alvarop/usb_c_cable_tester/img/front_v2.4.jpg

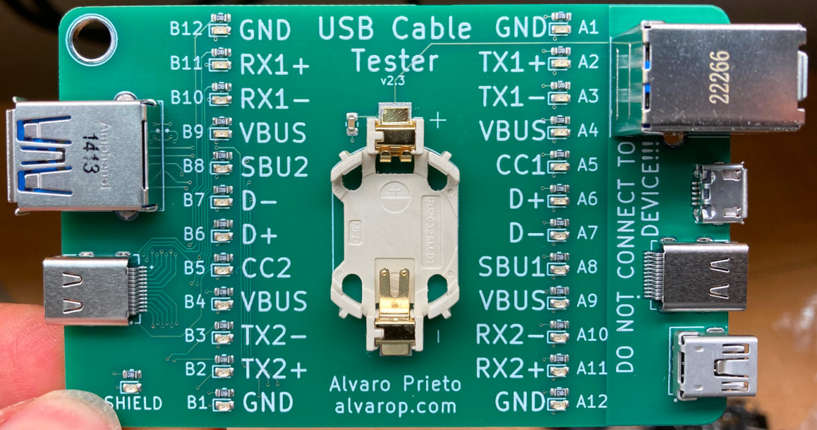
img/front_v2.4.jpg
