alvarop/usb_c_cable_tester/(threads)

Thread 2 (2022-11-21):

Unsure if JLCPCB got this right

voltagex, 2022-11-21:
(this would be better suited for GitHub Discussions but they're not enabled here)

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

I've sent them your photos back - it looks like they've dropped most of the parts off the board!

alvarop, 2022-11-21:
@voltagex This is correct. The left side is what they will use :D
It is confusing though

voltagex, 2022-11-21:
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

To me it seems like there's only 3 components they're going to use? Some connectors are missing?

I guess I can just continue with the order and see what arrives.

voltagex, 2022-11-21:
OK, yeah, the 2D render seems correct.
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

alvarop, 2022-11-22:
:D

voltagex, 2022-11-29:
This arrived today. I can get it to light up by probing with a multimeter, but not with a coin cell inserted. I do not like the battery holder at all

tedder, 2022-11-29:
I would *love* to just get this off Tindie.

alvarop, 2022-11-29:
Yeah, the battery holder isn’t great, you have to make sure you go over the negative and under the positive.
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

Closed 2022-11-22.

Thread 3 (2022-11-21):

Sockets for USB 3

ThorstenWirth, 2022-11-21:
Instead of the USB 2 sockets for micro and type B you should use the USB 3 versions.

alvarop, 2022-11-22:
I was going to, but JLCPCB didn't have them in their parts library :'(

Closed 2022-11-22.

Thread 6 (2022-12-13):

Consider USB-C connector with vertical pins for better soldering

vicnaum, 2022-12-13:
Consider using one of these for USB-C (where the second row of pins sticks out down and goes into the holes through the board)
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

Should help with soldering to get less defects (my order of 5 boards came in with 4 of the boards not soldered well 😢 and only one  was perfectly working).

I guess it's a common pain of the surface USB-C connectors - seen people complaining about them on the internet too - because the second row is hidden on the bottom of the connector and you can't really resolder it without detaching the whole thing.

alvarop, 2022-12-15:
Do you have an LCSC part number for this?
If JLCPCB has it in their supported parts library, I'd be down to switch to it in the future!

vicnaum, 2022-12-15:
> Do you have an LCSC part number for this? If JLCPCB has it in their supported parts library, I'd be down to switch to it in the future!

Yeah, there are many on their website:

- https://www.lcsc.com/product-detail/USB-Connectors_XUNPU-TYPEC-324-BCP24_C2835314.html
- https://www.lcsc.com/product-detail/USB-Connectors_XKB-Connectivity-USB31-TYPEC-32141-2FS_C319152.html
- https://www.lcsc.com/product-detail/USB-Connectors_XUNPU-TYPEC-324DBW-ACP24A_C2840399.html
- https://www.lcsc.com/product-detail/USB-Connectors_XUNPU-TYPEC-506BW-ACP24_C2895019.html
- https://www.lcsc.com/product-detail/USB-Connectors_Shenzhen-Kinghelm-Elec-KH-TYPE-C-24P-T9-87_C709359.html
- https://www.lcsc.com/product-detail/USB-Connectors_XUNPU-TYPEC-502-ACP17_C920229.html
- https://www.lcsc.com/product-detail/USB-Connectors_XKB-Connectivity-USB31-TYPEC-33141-2FS_C480368.html
- https://www.lcsc.com/product-detail/USB-Connectors_SOFNG-MC-313D_C428461.html
- https://www.lcsc.com/product-detail/USB-Connectors_XUNPU-TYC-324_C381479.html

I'm not sure what's the exact difference between then and which one is better, but plenty to choose from.

alvarop, 2023-06-11:
Hopefully fixed in https://github.com/alvarop/usb_c_cable_tester/releases/tag/v2.1

R3Q13M, 2023-06-12:
@alvarop since my fork was partially based around potential for hand soldering I spent a lot of time looking for the USB-C connector with the most easily accessible pins. I'd just like to recommend what I found since this could be a fantastic board for novice/intermediate solderers to put together by hand.

I settled on the [G-Switch GT-USB-7056](https://jlcpcb.com/partdetail/gswitch-GT_USB7056/C963222) and would be happy to share the footprint I made with you if you're interested in it.

Ardakilic, 2024-04-06:
Hello, I've created a new suggestion for USB-C connectors. After creating the issue/suggestion I stumbled upon this issue. So since you guys know about the stuff, I'd appreciate if you could check #20 and give feedback. Thanks!

Closed 2023-09-03.

Thread 7 (2022-12-15):

3D Printed/laser cut case

coryalder, 2022-12-15:
Hello!

My local hackspace recently did a group-buy of this project, and I got myself 2 of them. They works great and a will be very useful. To make sure they last me a while, I designed a 3d printed / laser cut case for it. It has a 3d printed body, and a laser cut plexy top panel so you can see the lights on the board. I just wanted to link it here in case anybody else is looking to enclose theirs.

https://github.com/coryalder/usb-c-tester-case

alvarop, 2022-12-15:
So cool! Thanks for sharing!

Going to add a link in the readme later so other folks can make their own :D

alvarop, 2022-12-16:
I've added a link in the readme. Thanks again!

Closed 2022-12-16.

Thread 8 (2023-01-04):

Consider using 0.3mm vias

smesgr9000, 2023-01-04:
First of all - Thanks for sharing the PCB layout

It would be nice if the via size is increased to 0.3mm - reason I want to use PCBWay for manufacturing the PCB and cost for 5 PCBs increase from 5USD to ~50USD due to via size been smaller than 0.3mm.

I did a quick hack to increase the via size and moved some tracks and placed an order - which is currently processed. I can share my hack if you want - but you are properly better at this than me. :sob:

alvarop, 2023-06-11:
I'll try to get this later. I just did a new spin with updated components, but didn't have the time to update all the vias. Plus the new USB-C connector probably also requires fancy boards due to the spacing :/

R3Q13M, 2023-06-12:
@alvarop thanks for looking into this. I actually forked the design for myself to address this issue as well as issue #10 but haven't gotten very far. I'd just like to suggest that good rule of thumb for via annular ring size for low-cost PCB's is via diameter plus around 12mils. So I'd recommend for a 0.3mm via a ~0.6mm diameter annular ring.

Also, these through-hole USB-C connector holes are 0.4mm, 0.65mm annular ring, and pitched 0.8mm apart. Therefore, the minimum copper spacing is 0.15mm. For most fabs 0.15mm is about the limit for their low-cost tiers.

Thread 9 (2023-01-26):

USB 3.0 Type B instead USB-type A

smesgr9000, 2023-01-26:
Another suggestion would be to replace the USB 2.0 type B with an USB 3.0 type B plug. Like:
https://www.lcsc.com/product-detail/USB-Connectors_XUNPU-USB-306BWD-ARW_C2895032.html

This is downward compatible with earlier USB 2.0 plugs so could be used for older downward cables and newer ones.

alvarop, 2023-06-11:
Added in https://github.com/alvarop/usb_c_cable_tester/releases/tag/v2.1

Closed 2023-09-03.

Thread 10 (2023-01-30):

Keep cable shield and ground on separate nets

avian2, 2023-01-30:
Hi

Thanks for sharing this project. I've ordered a batch and gave the extras to friends and family.

A suggestion for the next version: keep cable shield and ground on separate nets. With v2.0 all four GND and the SHIELD LED will light up as soon as any of the ground pins and/or cable shield are connected. This is misleading, because the SHIELD will light even for cables that do not have a shield braid (i.e. do not have an electrical connection between the connector shell - this seems to be quite common in my experience).

smesgr9000, 2023-03-05:
this is an issue of the currently USB-C jack used. There is already a suggestion to switch the USB-Jack to an through hole one, which may also solve this issue.

Use the current USB-C an measure Shield with the outer pins on both rows and it will show continuity.

avian2, 2023-03-05:
You're right that the A1, B1, A12, B12 (USB C ground pins) and shield are already routed separately on the PCB. I only checked with a multimeter and haven't looked at the design files.

I find it odd that these would be intentionally shorted to shield on the connector. I don't find any note about that on the datasheet for Molex 1054500101 (the USB C connector specified in the BOM). A quick search through the USB C spec also doesn't show this (The connector should have all ground pins shorted together, but there is no mention of shorting them to shield in the connector itself). There might be something else going on.

I think I should have some USB C connectors stashed somewhere. It's not this specific type, but I'll check if those have the ground pins shorted to shield.

Looking at the Gerbers, one possibly related error I found are the bare vias under the USB C connector. These are in the restricted area of the connector. They should be covered with soldermask so that exposed copper can't touch metal parts of the connector. It's possible one of these is shorting to the shield somewhere. Since A1, B1, A12 and B12 are all shorted together in the connector, only one of B1 or B12 contacting the shield would be enough to show as short to shield from all of them. Although it would be an odd coincidence if only one of the ground pins would have a short and not any others.

Image below is from the v2.0 Gerbers. Blue is top copper, yellow is top soldermask (inverse).

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

smesgr9000, 2023-03-05:
no trust me - I have thorn it apart and there is a bracket which is wrapped around and have all 4 GND pins connected AND also the shield. I even tried to remove this bracket and put it back together but this would not work out.

Additionally I would say for hand soldering the connector would not be my first choice anyway.

avian2, 2023-03-05:
Odd.

I quickly buzzed out an old PCB of mine I just dug out of a drawer. It uses Wurth 632723300011. That's a USB C connector that has B1 through B12 on THT pins instead of SMT pads. It's similar to one discussed in #6.

It doesn't have the shield shorted to ground.

I can't check if A1, B1, A12 and B12 are shorted together on connector, because they are shorted on my PCB.

R3Q13M, 2023-05-09:
The Molex connector has a set of extra pins that get bridged to pins B1 and B12 because of the extra wide 'B1' and 'B12' pads in the footprint. I suspect these extra pins are connected to the connector shield. Can you modify the footprint to un-bridge these pins?

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

alvarop, 2023-06-11:
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

Confirmed, it has separate pins, but they're internally shorted. I tried them out on a disconnected part and they're still internally connected :(

R3Q13M, 2023-06-11:
Oh that's really unfortunate. Thanks for checking. Do you plan to address this issue with a new part?

alvarop, 2023-06-11:
Yeah, going to try another part for now

alvarop, 2023-09-03:
Fixed in v2.1 and later :D

Closed 2023-09-03.

Thread 12 (2023-05-25):

Micro-B connector does not sit flush with board

catequalsgood, 2023-05-25:
Because of the bent lower lip of the micro-B port colliding with the board (see below) the part does not sit flush and can break off (it did on one of my boards anyway). The reference PCB layout (https://jlcpcb.com/fa9c3917-bd5c-4804-b018-3fa44680ab2e) seems so suggest a clearance of 0.7 mm between the board edge and that bent part of the connector.

Thank you for providing these files! Certainly a very useful tool to have around.

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

alvarop, 2023-06-11:
Hopefully addressed in https://github.com/alvarop/usb_c_cable_tester/releases/tag/v2.1

alvarop, 2023-09-03:
Fixed in v2.1 and later

Closed 2023-09-03.

Thread 13 (2023-06-02):

Interpreting the results?

grymoire, 2023-06-02:
If a signal is missing, I'm not sure I can tell that there is a problem. It would be nice to have a chart that shows/lists the LED's that are suppose to be on for certain cable types.

grymoire, 2023-10-19:
A similar product has a manual, and includes a helpful guide.
[C2C-caberQU PDF](https://github.com/petl/USB-C-cable-tester-C2C-caberQU/blob/main/documentation/v3/caberQU_manual_v3.2_compressed.pdf)

Here's what page 7 shows

**USB Power Delivery**
- Option A: VBUS | GND | CC1 | Shield
- Option B: VBUS | GND | CC2 | Shield

**USB 2.0/1.1**
- Option A: VBUS | GND | D+ | D- | Shield

**USB 3.0/3.1/3.2/4**
- Single lane (3.0/3.1)
-- Option A: VBUS | GND | TX1+ | RX1+ | TX1- | RX1- | Shield
-- Option B: VBUS | GND | TX2+ | RX2+ | TX2- | RX2- | Shield
- Dual lane (3.2/4)
-- Option A: VBUS | GND | TX1+ | RX1+ | TX1- | RX1- | TX2+ | RX2+ | TX2- | RX2- | Shield

**Debug Accessory Mode**
- Option A: VBUS | GND | D+ | D-| CC1 | SBU1 | TX1+ | RX1+ | TX1- | RX1- | Shield
- Option B: VBUS | GND | D+ | D-| CC2 | SBU2 | TX2+ | RX2+ | TX2- | RX2- | Shield

**Alternate Mode**
- Option A: VBUS | GND | TX1+ | RX1+ | TX1- | RX1- | Shield
- Option B: VBUS | GND | TX2+ | RX2+ | TX2- | RX2- | Shield

**Audio Adapter Accessory Mode**
- Option A: GND | CC1 | CC2 | SBU1 | SBU2 | D+ | D- | Shield
VBUS is optional for concurrent charging of a device.

NSExceptional, 2024-01-11:
It's a shame the author hasn't responded. Is that chart enough for a lowly coder to use to organize his USB cables in your opinion, @grymoire?

ejl371, 2024-01-26:
Wikipedia tells you what pair does and what modes it is used in.  https://en.wikipedia.org/wiki/USB-C.  The author is amazingly responsive when I reached out to ask about another issue.  Which coincidentally someone else opened the same day (issue 18).

anyconhhv, 2024-01-29:
I gathered all of my cables and tested them. I then attached a label to each with the type of USB. And then if a cable doesn't work, I try a cable with more connections.  There is an amazing number of variations in type and price, especially in USB-C cables. I have photos of a couble that might help.

This first one was an expensive cable -  All lines are on exzcept for D+/D- on one side, but if you flip the USB3 cable over, the D+/D- on the other side lights up.
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

Now here's cable #2. I am not sure how this cable was classified. Note that how I plug it in, there are three different combination of light patterns.
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

Now flipping over the USB-C, note how TX2/RX2 become TX1/RX1
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

And now plugging into the green USB2 port instead of the blue USB3 port, we just get VBus/Gnd and D+/D-. Note we have 2 sets of Gnd/VBUS/
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

Here's a USB-C to USB-C cable I use for fast charging. Note it has two sets of VBus/Gnd and D+/D-, but there is also a CC2 light. If I flip the cable over, CC2 on the left changes to CC1 on the right.

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

And finally - a plain, ordinary  USB2 data cables -  with one set of VBus, ground and D+/D-.
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

grymoire, 2024-01-29:
Oops. I submitted the above info on my other account. I'm also [anyconhhv](https://github.com/anyconhhv)

Thread 14 (2023-06-12):

USB 3.0 connector

MZelenyElatec, 2023-06-12:
Hi,

Where can I get the USB 3.0 connector? I there any compatible connector from Molex or similar which I can get on Digikey instead of some chinese shop?

BR

alvarop, 2024-02-11:
Unfortunately not. See my response here for more info: https://github.com/alvarop/usb_c_cable_tester/issues/18#issuecomment-1937881707

Closed 2024-02-11.

Thread 16 (2023-07-19):

Manufacturing defects on the new USB-C receptacle

FHeilmann, 2023-07-19:
Hi, thank you for sharing this board!

Unfortunately JLCPCB seems to have issues assembling the new USB-C receptacle. I've ordered 5 assembled PCBs and while the USB2.0 and even the 3.0 A-to-C works ok on 3 or 4 of them, pretty much all of them have issues with the 3.0 C-to-C cable testing.

With a known good USB-3 C-to-C cable, each board shows a different combination of LEDs, on some, even the basic pins such as D+ and D- stay dark, which leads me to believe that the assembly of the Type-C receptacles is faulty.

I've put in a support request with them, let's see how it goes.

edit: Just read the note on the 2.1 pre-release. D'oh. Well thats what I get for not reading everything :D

alvarop, 2023-07-29:
Hey! Yeah, it was a bummer. I think it would work better with a 0.8mm PCB.
I still need to do an order with that one and see if it helps.
I was able to "fix" many of them manually with a soldering iron but it's a pain...

The previous connector that was SMT only was great, but it shorts all the ground pins together with the shield :(

alvarop, 2023-09-03:
I changed to use 0.8mm PCB's (instead of 1.6mm) and had MUCH better results. 95% yield :D
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

1/20 boards had some solder bridges on the USB-C connector, but it was easy to fix.
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

Not all of the boards had the soldermask missing between the pins though. Might have to slightly change the footprint to improve the chances of the mask being there.

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

The through hole pins had much better soldering on them:
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

Closed 2023-09-03.

Thread 18 (2024-01-24):

Cannot order from JLCPCB because FOXCONN UT11113-11602-7H is unavailable

MacLemon, 2024-01-24:
Thanks for the excellent instructions on how to order a populated PCB through JLCPCB. They help people like me who aren't familiar with PCB making and ordering.

Connectors `J1`, `J2` are a `FOXCONN UT11113-11602-7H` which hasn't been in stock at JLCPCB for about two months now. As a consequence I'm unable to order a PCB since I lack the skills to pick a suitable replacement receptacle.

Would it be possible to update the BOM with an alternative Type-C receptacle that is available or use a different PCB manufacturer instead?

alvarop, 2024-01-24:
Hi Marc,
This is the unfortunate side effect of using whatever was available at the time. I'll have to redesign the board to use a more commonly used connector. I may be able to do it this weekend, but I'm not sure.

I'll make sure to update here and add a new release when that happens.

lnrdmx, 2024-01-26:
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
same, appreciate your work alvarop!

alvarop, 2024-02-11:
Hi again.

Taking a look at the JLC USB-C connector inventory and it's not great. There's only one option that even has more than 1000 in stock. I'm afraid this will become never ending if I have to keep re-designing whenever a connector goes out of stock.

The other option is to design it with commonly available connectors, which means the price will be much higher and manufacturing process not as simple, since they won't be in the JLC parts library.

At this point, if you really need one, you can get something on amazon for cheaper: https://www.amazon.com/Treedix-Cable-Checker-Charging-Type-C/dp/B0BW8ZC7YD

ejl371, 2024-02-11:
Thank you for looking into it.

ejl371, 2024-02-19:
FYI, The USB C connector is back in stock.

alvarop, 2024-02-20:
Thanks for the update!

alvarop, 2024-08-17:
Closing this one. If they're available, that's great, but if not, you can build v2.4 with more commonly available parts here: https://github.com/alvarop/usb_c_cable_tester/releases/tag/v2.4

Closed 2024-08-17.

Thread 19 (2024-03-21):

Suggestion: Make SMD pads for LEDs and resistors hand solderable

Ardakilic, 2024-03-21:
Hello,

I'd appreciate if the pads were hand solderable for LEDs and resistors.

As far as I know, there are two types of SMD footprints on Kicad. One for machine soldering, and the other for hand soldering.

The footprint is included in the library, and it's almost identical, only except the hand solderoable one has a tiny wider pads to use soldering iron by hand. There's almost no difference.

I hope this won't change the PCB design much, anything at all. Since I like and prefer soldering by hand, I'd appreciate if this is considered.

Thanks in advance!

Thread 20 (2024-04-06):

Suggestion: Change USB-C connector to a widely available and cheaper 24p one

Ardakilic, 2024-04-06:
Hello,

First of all, thank you for open-sourcing the project.

Today I have built the tester myself, and realized the usb-c connector that I've purchased does not fit properly to the case.

This is because the pinout is somehow different.

After confirming the pins match, I have bought this: $1.91 / 10 pcs:

https://www.aliexpress.com/item/32879436811.html

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

However, today I realized the ground shielding does not fit.

I used a wrench and my soldering techniques. It fits and works.

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

To change to the proper connector, I searched, and in Aliexpress, there are only 2 sellers, which I believe sells the item and fits to the footprint. I thought these should be widely available.

The closest one, which I could find available is this, and it costs $1.4 per part, https://www.aliexpress.com/item/1005005376413109.html

And it's almost 10 times more expensive than what I've bought, even more expensive than LCSC.

There are various connectors that are 24 pin and pinouts match 1:1, and available at LCSC, where the footprint matches, widely available in other vendors, and they are way cheaper:

For example:

* $0.52 per connector, and the most available part on the category: https://www.lcsc.com/product-detail/USB-Connectors_XUNPU-TYPEC-324-BCP24_C2835314.html
* $0.25 per connector- https://www.lcsc.com/product-detail/USB-Connectors_Lian-Xin-Technology-XUBF-0336-B07_C7527707.html
* $0.46 per connector- https://www.lcsc.com/product-detail/USB-Connectors_SHOU-HAN-TYPE-C-24P-QCHT_C456013.html
* $0.45 per connector- https://www.lcsc.com/product-detail/USB-Connectors_Hanbo-Electronic-MC-263-H20_C6332283.html
* $0.36 per connectorhttps://www.lcsc.com/product-detail/USB-Connectors_HCTL-HC005-1A1H1A103-0HR_C2894904.html
* Discontinued, but you get the idea: https://www.lcsc.com/product-detail/USB-Connectors_XUNPU-TYC-324_C381479.html

There are a lot of more connectors, these are just the results of my humble 5 minutes of searching.

The greater issue is that the lack of availability of the part, apart from the price, as I mentioned.

I reside in Turkey, and my best bet is Aliexpress. After that there is Farnell Turkey, which they don't stock much, and ozdisan.com , and they both lack the connector.

And in Aliexpress, I found only two sellers, as I mentioned.

The pinout is same for both 24 pins, as I checked the footprint: Both SMD 12 pins, and the through hole other 12 pins, so I see no problem on switching the footprint to this widely available footprint model.

I'd appreciate if this is considered.

Thanks in advance!

exetico, 2024-05-04:
Hi,

I just stumbled upon the project, and noticed your issue, as I noticed the pretty high price of the C2761408, currently used in the design (8,43 USD for 10 Qty).

So I'll just bump this, so I can follow the process. It's the most expensive part of the BOM, so I guess there's many options to bring down the cost a bit, by replacing the connector with a cheaper one, as you're also suggestion. I'm not going to risk ordering it with another connector, without having a input from the original author, though. 😄

Thanks for bringing this to the table.

Ardakilic, 2024-05-08:
@alvarop Thanks for the reply.

The main issue I find with the current footprint is that it's not a rather generic one, so you're stuck with less brands (both in JLC/LCSC and other vendors). All of the links I've shared (and even more on LCSC's inventory) share the same footprint. That's why I suggested in the first place.

Of course, the price is a bonus, however, my main concern is the availability, and as you mentioned, current stock does not represent the future stock, that's why I believe a more generic footprint brings more alternatives and availability to the table.

alvarop, 2024-08-17:
I've created a hand-solderable one with commonly available parts here: https://github.com/alvarop/usb_c_cable_tester/releases/tag/v2.4

It's more expensive, but it won't require chasing component stocks as much.

Ardakilic, 2024-08-17:
Heya @alvarop , awesome to hear there's a hand solderable version now. Thank you for the heads-up, and thanks again for the work you've put into this!

Closed 2024-08-17.

Thread 21 (2025-01-17):

Conflicting Resistor Values for R1 to R25

petrepa, 2025-01-17:
First off, thank you for this fantastic project — we truly appreciate all the work that has gone into it.

We’ve encountered an issue with the resistor values for R1 to R25 while communicating with the manufacturer. There seem to be discrepancies between the project files:

- **Schematic (KiCad):** _330Ω_
  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
- **BOM Description:** _1kΩ_
  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
- **[LCSC Part Number](https://www.lcsc.com/product-detail/Chip-Resistor-Surface-Mount_UNI-ROYAL-Uniroyal-Elec-0603WAF2201T5E_C4190.html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):** _2.2kΩ_
  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

Could you kindly clarify what the correct value should be? This would help us ensure proper assembly and avoid potential delays.

Thank you in advance for your guidance!

petrepa, 2025-01-20:
Ok, thanks! That makes it clearer. I'll communicate it to the manufacturer.

Any idea on how we can make this more clear for other people wanting to build this project? 🤔 Some way we can update the README or BOM to avoid confusion?
