alvarop/usb_c_cable_tester/(commit log)

2022-08-28 Adding v1.0 of USB-C Cable Tester
    (also ordered from JLCPCB
    [usb_c_cable_tester.kicad_pcb, usb_c_cable_tester.kicad_sch]
2022-10-07 Update to 2.0
    All of the connectors!
    [usb_c_cable_tester.kicad_pcb, usb_c_cable_tester.kicad_sch]
2022-10-07 Fix BOM and footprint
    [usb_c_cable_tester.kicad_pcb]
2022-11-19 adding assembly instructions
2022-11-20 adding reference to USB-standard doc and compliance zip file... helps to understand what cables are legal in USB-standard, and how backwards-compatibility works with these cables
2023-06-11 v2.1 Update
    * Updated USB-C Connector to the [Foxconn UT11113-11602-7H](https://jlcpcb.com/partdetail/Foxconn-UT11113_116027H/C2761408)
    * Hopefully this resolves #6 and #10
    * Updated USB-B connector to a USB3 one [XUNPU USB-306BWD-ARW](https://www.lcsc.com/product-detail/USB-Connectors_XUNPU-USB-306BWD-ARW_C2895032.html) (Thanks @smesgr9000!) #9
    * Changed USB Micro-B connector to a hopefully more robust one and also moved closer to board edge #12
    [usb_c_cable_tester.kicad_pcb, usb_c_cable_tester.kicad_sch]
2023-08-19 Updating to KiCad 7
    [usb_c_cable_tester.kicad_pcb, usb_c_cable_tester.kicad_sch]
2023-08-20 v2.2 Started using autogenerated easyeda footprints using https://github.com/uPesy/easyeda2kicad.py
    Also, going to build with 0.8mm PCB and see if that helps
    [usb_c_cable_tester.kicad_pcb, usb_c_cable_tester.kicad_sch]
2023-09-03 BOM fixes for v2.2
    [usb_c_cable_tester.kicad_sch]
2023-09-04 Ugh, not sure why this keeps reverting
    [usb_c_cable_tester.kicad_sch]
2023-09-05 Remove stale LCSC properties
    [usb_c_cable_tester.kicad_pcb, usb_c_cable_tester.kicad_sch]
2023-10-08 Who knows what kicad is doing...
    [usb_c_cable_tester.kicad_pcb]
2024-06-30 v2.3 Using commonly available parts
    [usb_c_cable_tester.kicad_pcb, usb_c_cable_tester.kicad_sch]
2024-08-17 Remove power plane to make hand soldering a bit easier
    Also updated resisistors to 330 vs 1k
    [usb_c_cable_tester.kicad_pcb, usb_c_cable_tester.kicad_sch]
2026-05-02 Update to kicad 9
    [usb_c_cable_tester.kicad_pcb, usb_c_cable_tester.kicad_sch]
